Giuzzo/Giuzzo.github.io/404.md

---
layout: center
permalink: /404.html
---

# 404

Sorry, we can't seem to find this page's pixylls.

<div class="mt3">
  <a href="{{ site.baseurl }}/" class="button button-blue button-big">Home</a>
  <a href="{{ site.baseurl }}/contact/" class="button button-blue button-big">Contact</a>
</div>
