Giuzzo/Giuzzo.github.io/_posts/2015-06-25-1.8 progetazzione case - taglio laser - Copia.markdown

---
published: true
title: 1.8 Progettazione case - Laser Cut
layout: post
---

Tutti i pannelli di copertura esterni, e le sponde divisorie interne sono state ricavate da pannelli di parapan di 4mm di spessore.
Nello specifico sono stati utilizzati due pannelli di 1200 X 900 mm, e due panneli più piccoli di 600 X 300 mm.
Sono stati eseguiti dei test preliminari su alcuni provini di materiale per poter calibrare velocità è potenza del laser sul materiale in questione per le diverse lavorazioni necessarie (taglio ed engraving).
Il tempo macchina complessivo per realizzare tutte le lavorazioni è stato di circa 5 ore.

Di seguito i disegni di taglio:

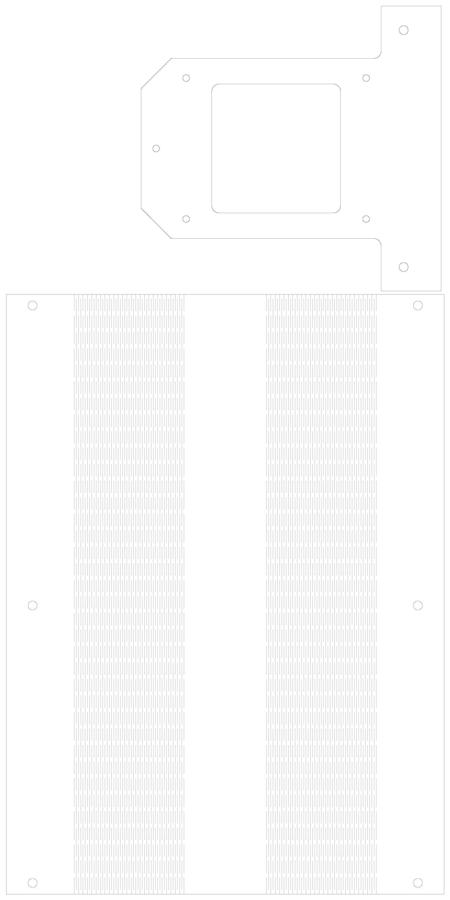
[picture p1: link_img/36.jpg]
laser1
 

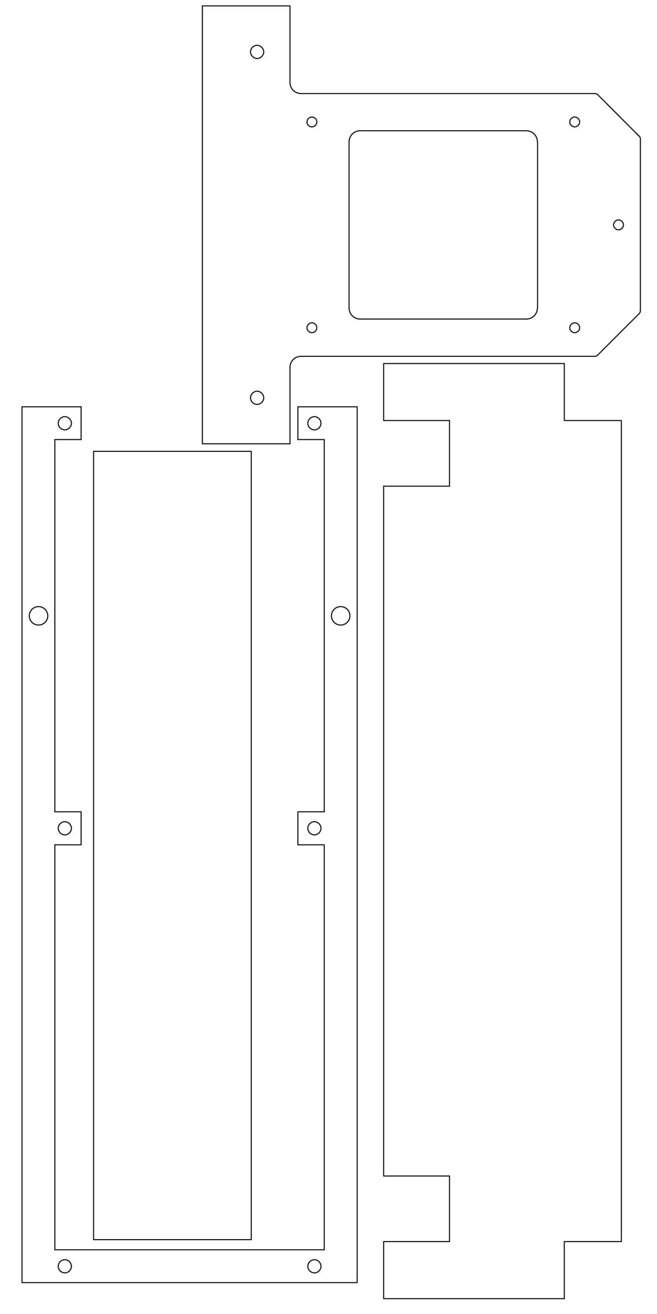
[picture p2: link_img/37.jpg]
laser2


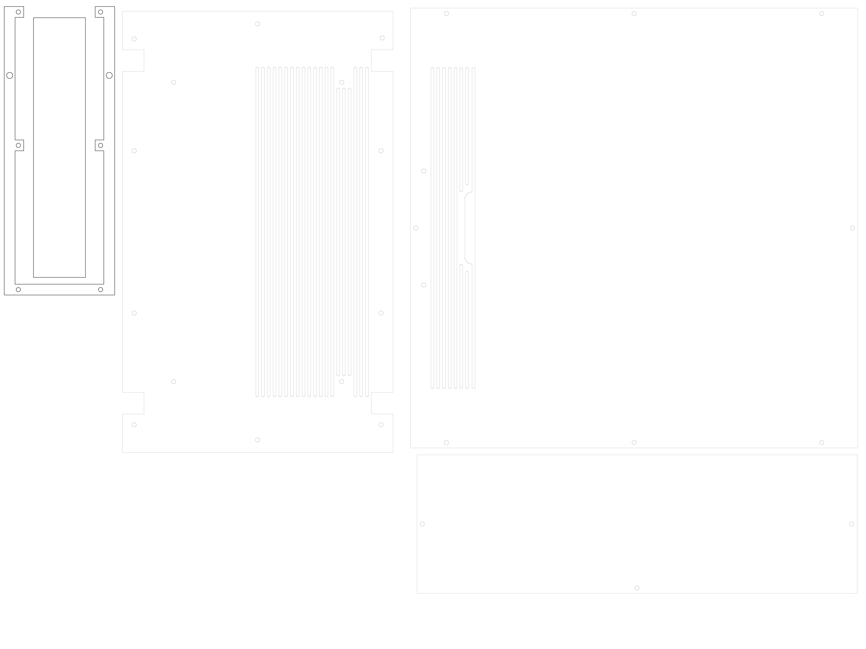
[picture p3: link_img/38.jpg]
laser3


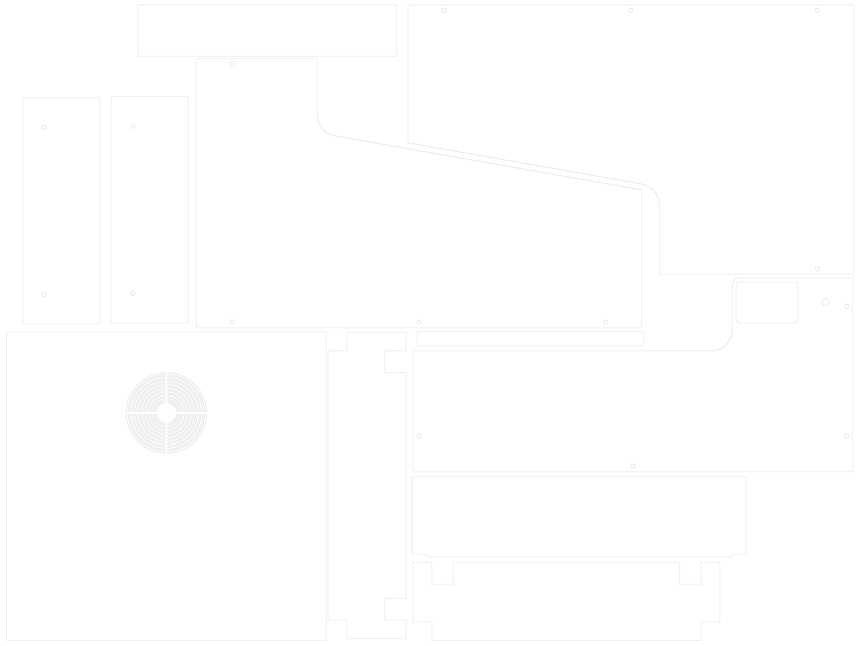
[picture p4: link_img/39.jpg]
laser4
