Giuzzo/Giuzzo.github.io/_posts/2015-05-22-1.4 modellazione 3drag.markdown

---
published: true
title: 1.4 Modellazione 3drag
layout: post
---
Parallelamente alle prime ipotesi di concept, e agli sketch preliminari del case si è proceduto con la modellazione digitale dei componenti e degli ingombri principali della stampante. 
Le istruzioni per il montaggio sono disponibili su [rep rap](http://reprap.org/wiki/3drag) parte dei componenti in formato STL sono invece pubblicate su [thingiverse](http://www.thingiverse.com/thing:203292/#files).

La modellazione è stata fatta con la versione studenti del software di modellazione parametrica [Autodesk Inventor](http://www.autodesk.it/products/inventor/overview). 

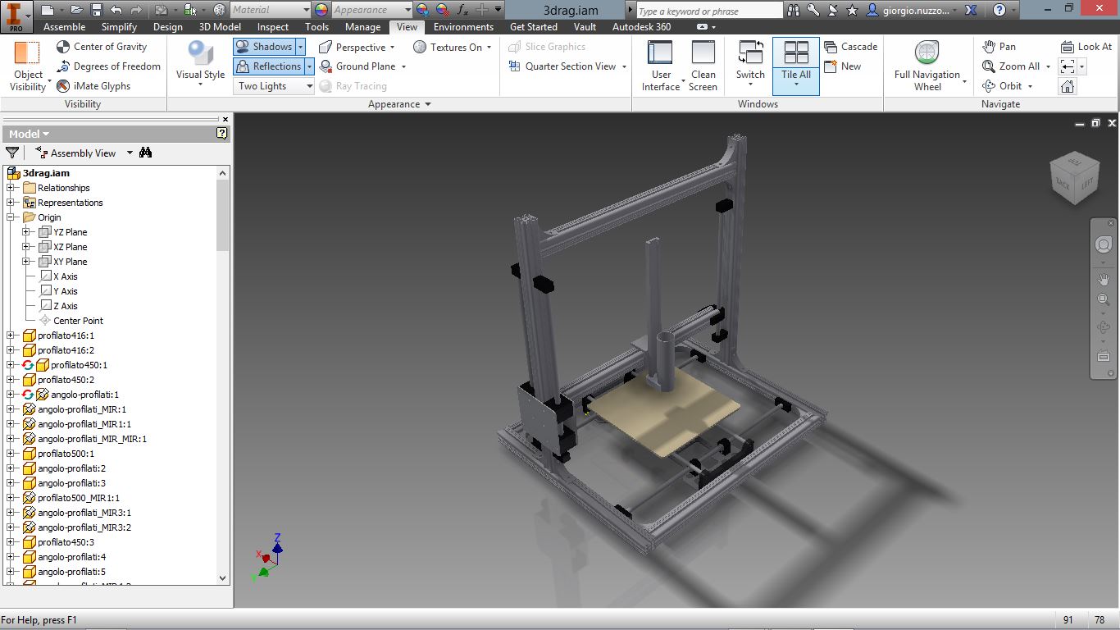
[picture p5: link_img/30.JPG]
3drag_model
