Giuzzo/Giuzzo.github.io/_posts/2015-05-16-0.1 hello-world.markdown

---
published: true
title: Hello world
layout: post
---
This is a test post for my new blog. The blog is hosted on [Github Pages](http://pages.github.com/) which means the source is available at [github.com/Giuzzo/Giuzzo.github.io](http://github.com/Giuzzo/Giuzzo.github.io). Be nice. Give credit. Share, don't steal :)

By the way, this blog is powered by [tinypress.co](https://tinypress.co).
