Giuzzo/Giuzzo.github.io/_posts/2015-05-21-1.3 progettazione case - stato dell'arte.markdown

---
published: true
title: 1.3 Progettazione Case - Stato dell'arte
layout: post
---
In prima battuta è stata fatta una raccolta di case history. 
Sono state analizzate in primo luogo macchine con funzioni analoghe e strettamente legate all'ambito alimentare, poi si è allargato il campo anche a tradizionali stampanti 3d e frese da banco.

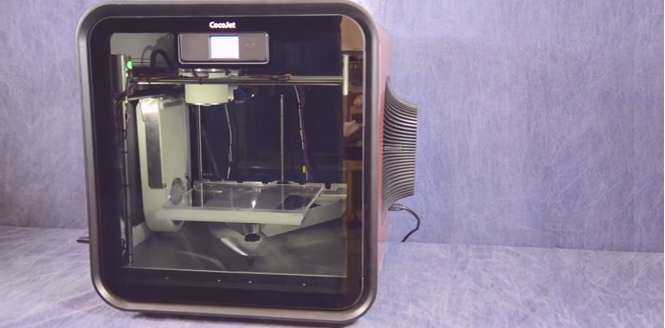
[picture p6: link_img/22.png]
CocoJet

[CocoJet](http://www.3dsystems.com/de/node/7563)

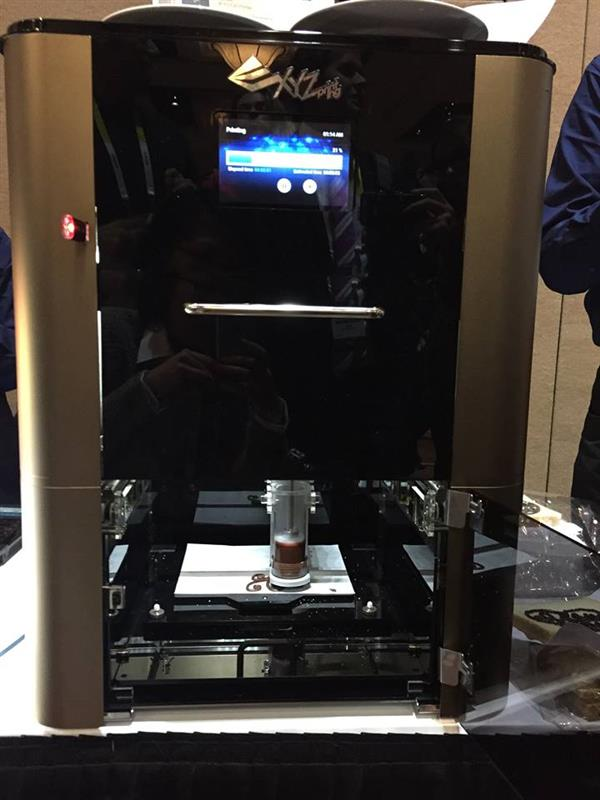
[picture p7: link_img/25.jpg]
xyz_printing

[xyz_foodprinting](http://www.cnet.com/products/xyzprinting-food-printer/)

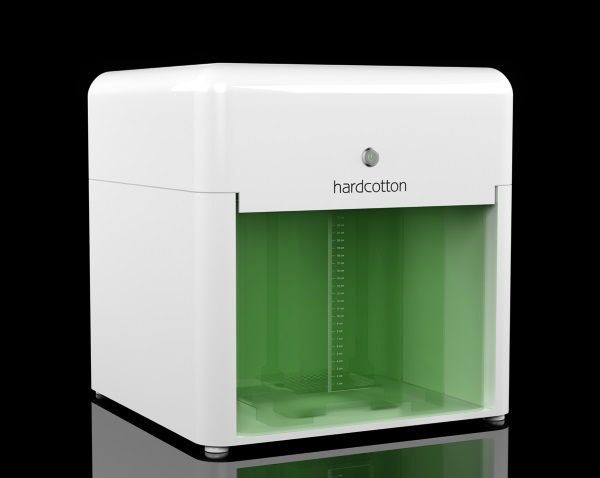
[picture p8: link_img/26.jpg]
hardcotton

[hardcotton](http://www.fabbaloo.com/blog/2014/11/21/hardcottons-sla-3d-printer-launches)

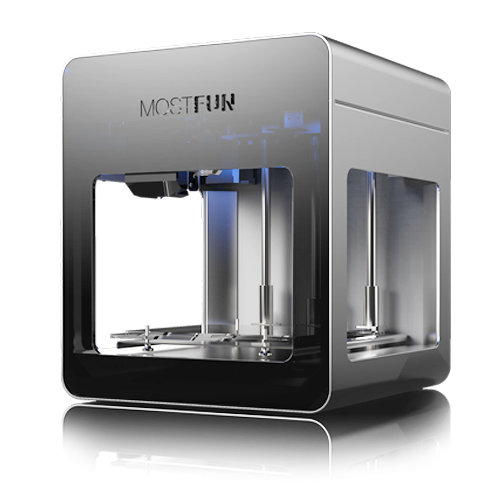
[picture p9: link_img/27.png]
mostfun

[mostfun](http://www.mostfun.cc/)

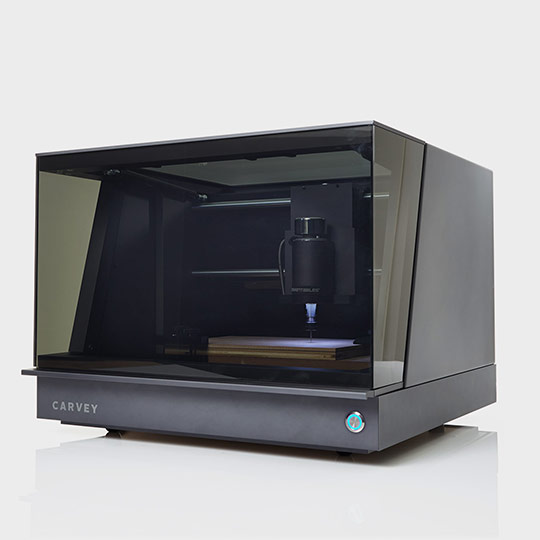
[picture p10: link_img/28.jpg]
carvey1

carvey2
[Carvey](https://www.inventables.com/technologies/carvey)

Ci è sembrato molto interessante in particolare l'espediente utilizzato dalla fresa [Carvey](https://www.inventables.com/technologies/carvey) riguardo l'apertura dello sportello, che risulta essere un'ottimo compromesso fra copertura della meccanica e dell'elettronica della macchina utensile e visibilita del "work in progress".
Questa ha infatti uno sportello di apertura trasparente che occupa la quasi totalità del fronte e solo parzialmente l'area superiore a laterale.
