Giuzzo/Giuzzo.github.io/_posts/2015-05-19-2.4 font monoline.markdown

---
published: true
title: 2.4 Font monoline
layout: post
---
Oltre ad i font selezionati si è cercato di svillupare un modo per poter ottenere un testo scritto con una linea unica continua (senza che l'estrusore si stacchi mai dal piano all'interno della stessa parola) in modo da ottenere un'effetto simile a quello di una **scrittura calligrafica**.

Il primo tentativo è stato quello di ottenere un STL in cui il corpo delle lettere fosse formato da una singola superficie e non da un volume.

Semplificando il problema alle due dimensioni,normalmente tutti i font hanno un proprio corpo che viene scalato in funzione delle proprie dimensioni.
E' stato possibile ottenere dei testi che fossero formati da una linea singola grazie ad un'estenione del software di grafica os [Inkscape](https://inkscape.org/).

L'estensione in questione utilizza dei Font Hershey, ed è scaricabile a  [questo link](http://www.evilmadscientist.com/2011/hershey-text-an-inkscape-extension-for-engraving-fonts/) nel quale sono presenti anche le istruzioni per l'installazione e l'utilizzo.

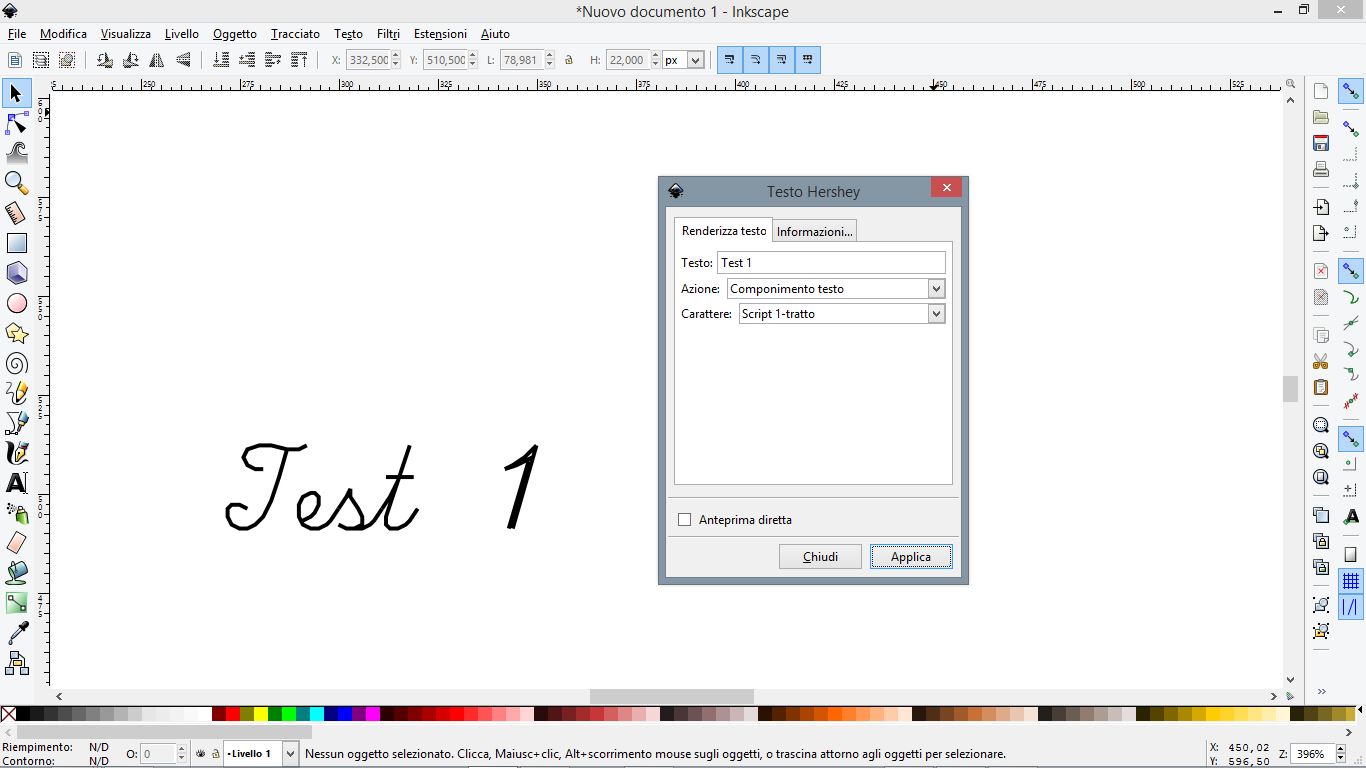
[picture p14: link_img/21.JPG]
testoHershey


Una volta scritto il testo desiderato è possibile esportarlo in un formato CAD e ricavare l'STL estrudendo la geometria su un qualunque programma di modellazione per superfici. Nel caso specifico è stato utilizzato il software [Rhinoceros](https://www.rhino3d.com/it/).

Ovviamente non è possibile in questo caso semplificare l'operazione con OpenScad come descritto nel [post precedente](http://giuzzo.github.io/2015/05/18/test%20di%20stampa%20font.html), in quanto non è possibile utilizzare softwares che lavorino per solidi in quanto questi non permettono l'estrusione di una linea senza spessore.

Cura tuttavia non riesce tuttavia a gestire correttamente lo slicing di singole superfici.

Risultati apprezzabili sono stati ottenuti però trasformando in Inskape il testo Hershey ottenuto da linea in tracciato pieno. In questo modo è possibile gestire il testo come se si stesse trattando con un font tradizionale, ma lo spessore del corpo dei caratteri è noto a prescindere dalle dimensioni generali del testo. 
Prima di eseguire la trasformazione occorre quindi assegnare al testo uno spessore di linea uguale, o prossimo alla dimensione dell'ugello impostata su Cura, dopodichè si può proseguire come [precedentemente descritto](http://giuzzo.github.io/2015/05/18/test%20di%20stampa%20font.html).

Tuttavia questa operazione, pur dando dei discreti risultati (non sempre ottimali), risulta un pò contorta e difficilmente automatizzabile in un futuro prossimo.
Sarà quindi necessario sperimentare nuove strade per ottenere migliori risultati.
