Giuzzo/Giuzzo.github.io/img/2015-05-17-presentazione2.png

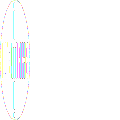
img/2015-05-17-presentazione2.png
