Giuzzo/Giuzzo.github.io/link_img/2-large_default.jpg

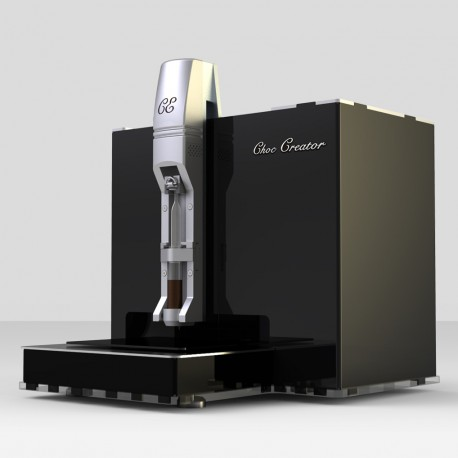
link_img/2-large_default.jpg
