Giuzzo/Giuzzo.github.io/link_img/6.jpg

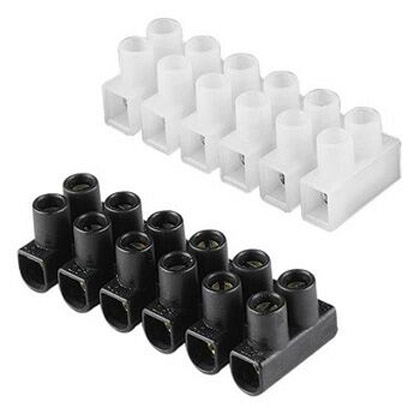
link_img/6.jpg
