Giuzzo/Giuzzo.github.io/link_img/7.jpg

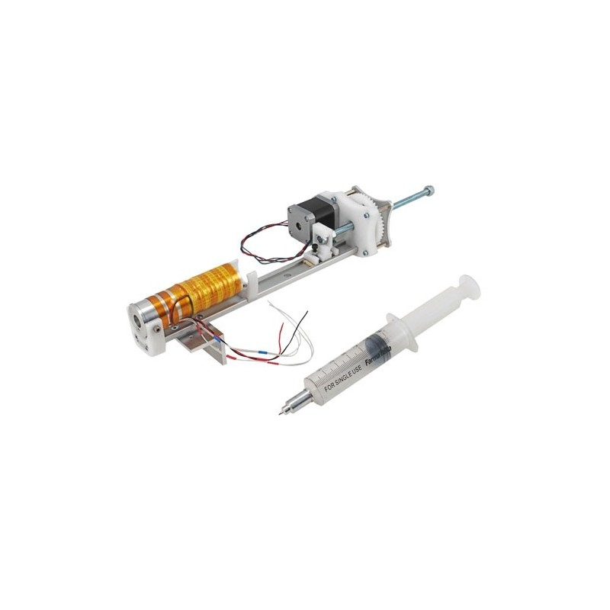
link_img/7.jpg
