Giuzzo/Giuzzo.github.io/link_img/23.jpg

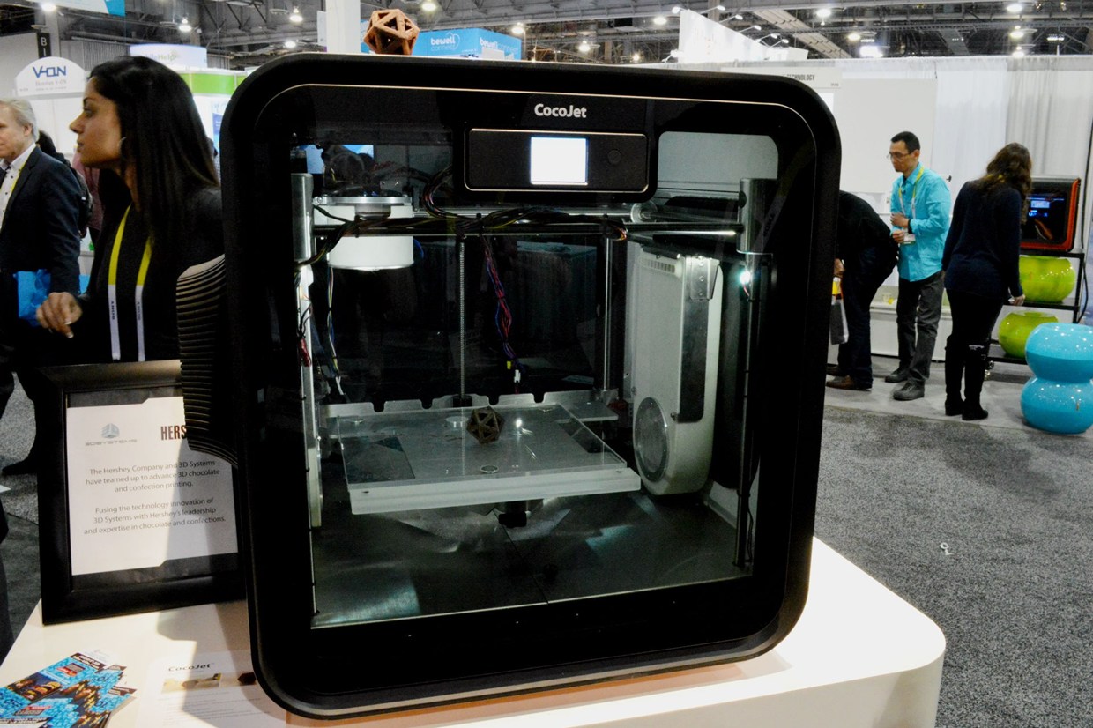
link_img/23.jpg
