Giuzzo/Giuzzo.github.io/link_img/24.png

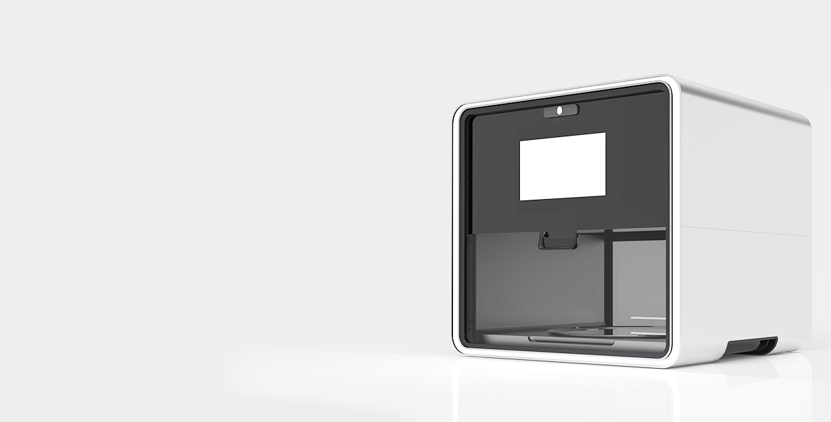
link_img/24.png
