Giuzzo/Giuzzo.github.io/link_img/29.jpg

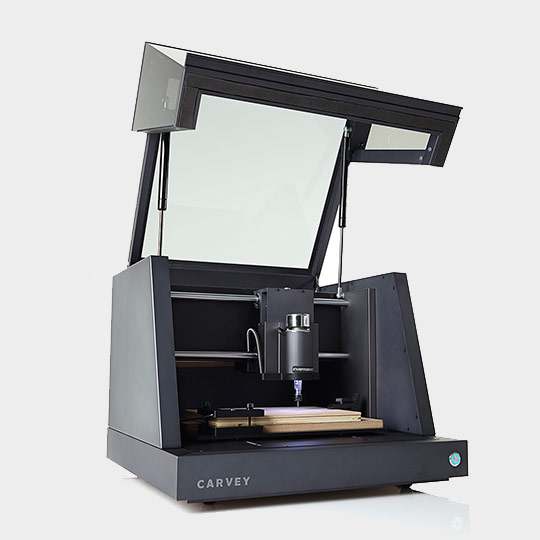
link_img/29.jpg
