Giuzzo/Giuzzo.github.io/link_img/34.png

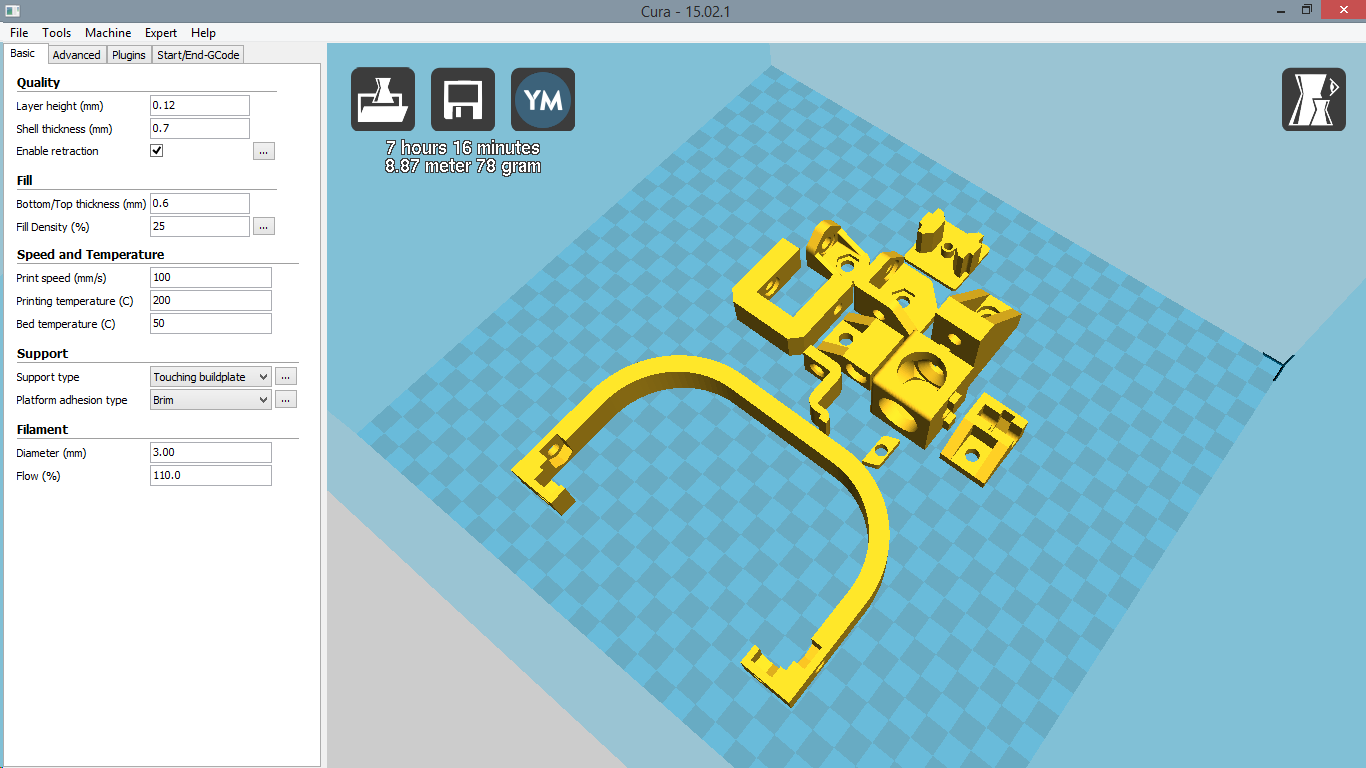
link_img/34.png
