Giuzzo/Giuzzo.github.io/link_img/35.png

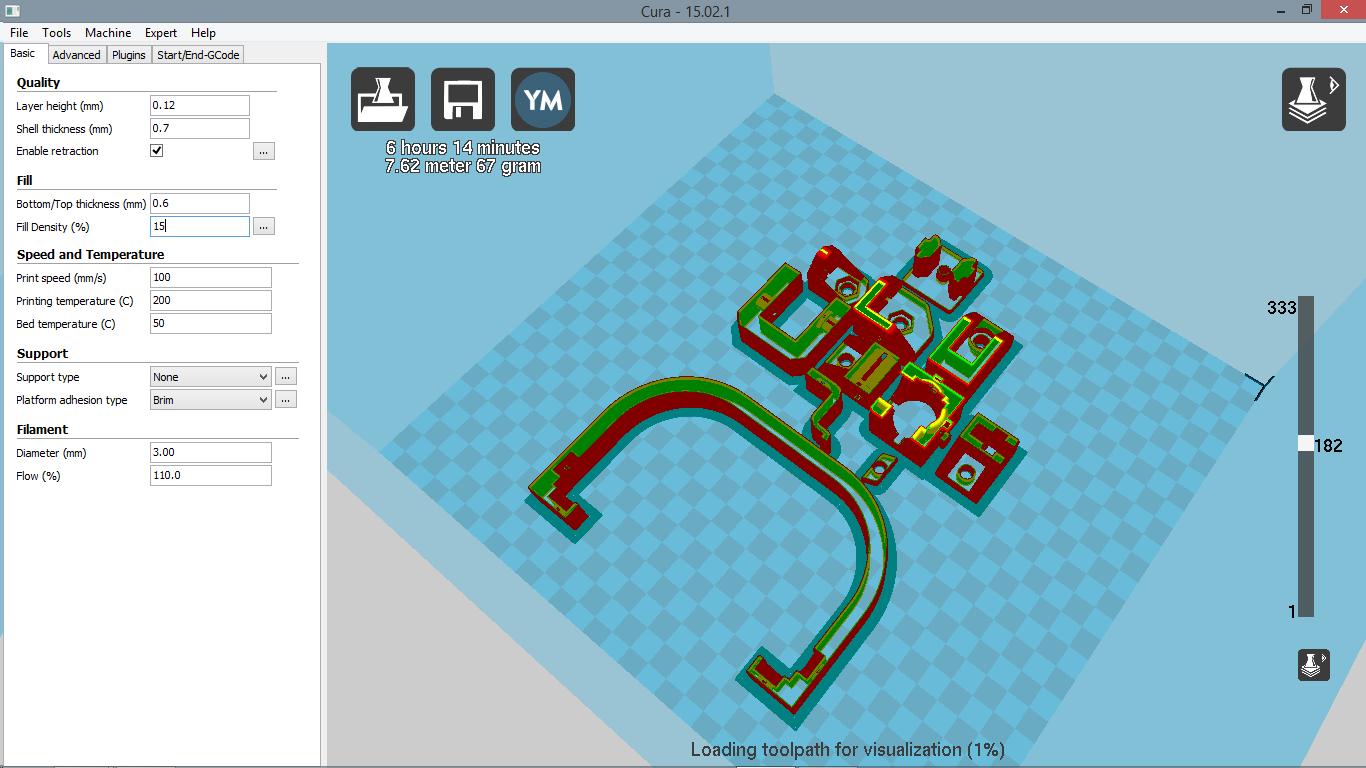
link_img/35.png
