Giuzzo/Giuzzo.github.io/_posts/2015-06-06-1.6 progetazzione case - bom.markdown

---
published: true
title: 1.6 Progettazione case - Bom
layout: post
---

Dopo gli sketch e le ipotesi preliminari si è iniziata la modellazione, cintemporaneamente all'ingenierizzazione del case, considerando sempre le tecnologie disponibili all'interno di WeMake.
Il telaio strutturale sara costituito da profilati in alluminio acquistati da un'azienda esterna, nella fattispecie [Dierre Toscana](http://dierre.eu/profili-e-sistemi-modulari/comp-di-assemblaggio-br-span-per-profili-span).

Di seguito delle immagine del modello digitale della configurazione finale del case, in fondo è riportata la distinta dei componenti utilizzati.

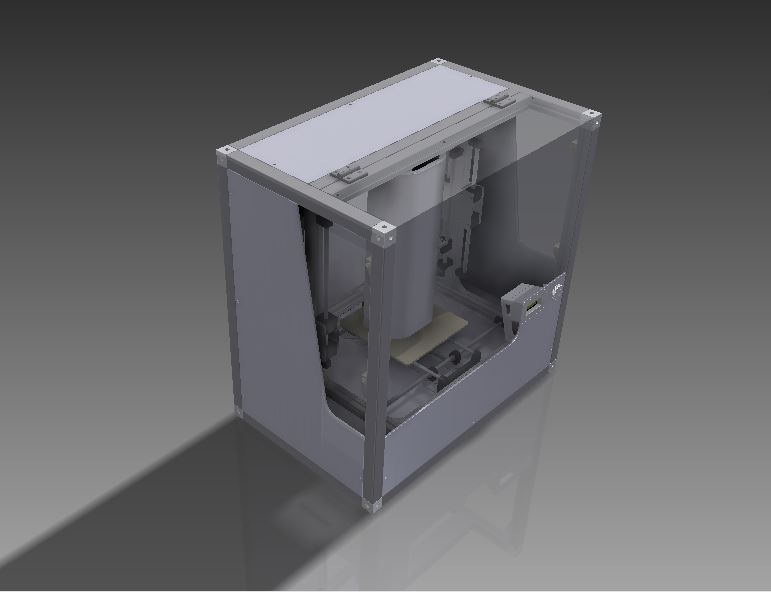
[picture p26: link_img/31.JPG]
case1


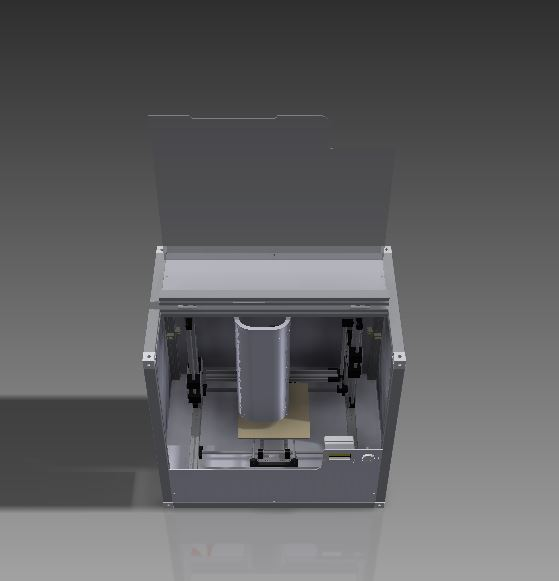
[picture p27: link_img/32.JPG]
case2


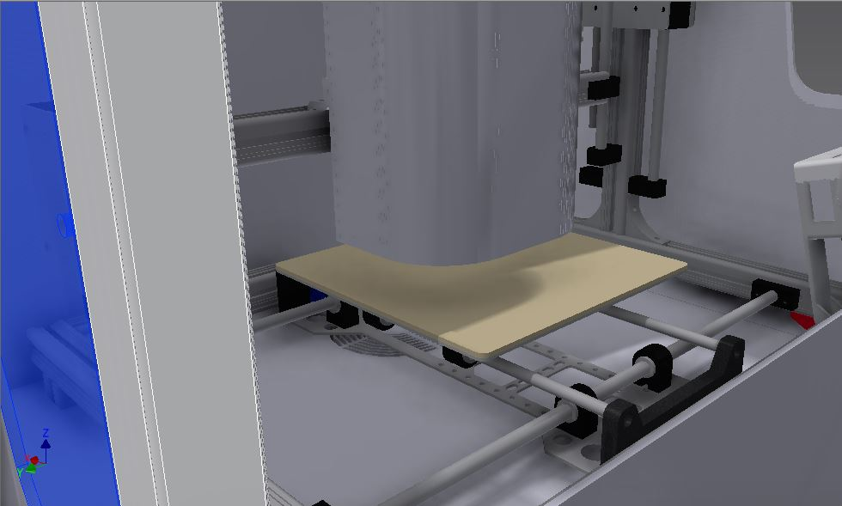
[picture p28: link_img/33.JPG]
case3


###Bill of Materials

| Assieme | Denominazione assieme | Parte | Denominazione| N° | M o B | Fornitore | Codice Fornitore | Dimensioni | Materiale | Lavorazione |
|:---:|:---:|:---:|:---:|:---:|:---:|:---:|:---:|:---:|:---:|:---:|
| 1 | 3drag | 1 | 3drag choko | 1  | B | FuturaElettronica | | | | |
| 2 | struttura portante | 02.01 | profilati verticali | 4  | B | DierreToscana | 01.30.30.2A | L 620 mm | alluminio | |
| | | 02.02 | profilati orizzontali | 3  | B | DierreToscana | 01.30.30.2A | L 610 mm | alluminio | |
| | | 02.03 | profilati orizzontali/lato | 4  | B | DierreToscana | 01.30.30.2A | L 375 mm | alluminio | |
| | | 02.04 | profilati orizzontali/cave180 | 2  | B | DierreToscana | 01.30.30.2.180A  | L 610 mm | alluminio | |
| | | 02.05 | cerniere | 2  | B | DierreToscana | 15-163-00 | | alluminio | |
| | | 02.06 | profilati di collegamento 3drag | 4  | B | DierreToscana | 01-3030-4A | L 136 mm | alluminio | |
| | | 02.07 | giunti angolari | 8  | M | | | | PLA | 3d printing |
| | | 02.08 | supporto piedini | 4  | M | | | | PLA | 3d printing |
| | | 02.09 | piedini | 4  | M | FuturaElettronica | | | | |
| 3 | schocche | 03.01 | blocco pannelli | 41 | M | | | | PLA | 3d printing |
| | | 03.02 | staffa angolare foro/foro | 2  | M | | | | PLA | 3d printing |
| | | 03.03 | staffa angolare foro/dado | 4  | M | | | | PLA | 3d printing |
| | | 03.04 | staffa angolare  dado/dado | 6  | M | | | | PLA | 3d printing |
| | | 03.05 | giunto basso | 2  | M | | | | PLA | 3d printing |
| | | 03.06 | giunto basso mirror | 2  | M | | | | PLA | 3d printing |
| | | 03.07 | fissaggio base inferiore | 6  | M | | | | PLA | 3d printing |
| | | 03.08 | giunto a U superiore | 2  | M | | | | PLA | 3d printing |
| | | 03.09 | pannello piano inferiore | 1  | M | | | | parapan 5mm | laser cut |
| | | 03.10 | pannello superiore | 1  | M | | | | parapan 5mm | laser cut |
| | | 03.11 | pannello posteriore | 1  | M | | | | parapan 5mm | laser cut |
| | | 03.12 | piano superiore fisso | 2  | M | | | | parapan 5mm | laser cut |
| | | 03.13 | binario piano superiore | 2  | M | | | | parapan 5mm | laser cut |
| | | 03.14 | piano superiore scorrevole | 1  | M | | | | parapan 5mm | laser cut |
| | | 03.15 | sponda divisoria frigo | 1  | M | | | | parapan 5mm | laser cut |
| | | 03.16 | sponda divisoria laterale | 2  | M | | | | parapan 5mm | laser cut |
| | | 03.17 | pannello opaco destro | 1  | M | | | | parapan 5mm | laser cut |
| | | 03.18 | pannello opaco sinistro | 1  | M | | | | parapan 5mm | laser cut |
| | | 03.19 | pannello frontale | 1  | M | | | | parapan 5mm | laser cut |
| | | 03.20 | pannello trasparente destro | 1  | M | | | | plexy 3mm | laser cut |
| | | 03.21 | pannello trasparente sinistro | 1  | M | | | | plexy 3mm | laser cut |
| | | 03.22 | sportello front | 1  | M | | | | plexy 3mm | laser cut |
| | | 03.23 | sportello up | 1  | M | | | | plexy 5mm | laser cut |
| | | 03.24 | saette sportello | 2  | M | | | | plexy 5mm | laser cut |
| 4 | copri-estrusore | 04.01 | dima estrusore | 3  | M | | | | PLA | 3d printing |
| | | 04.02 | copri-estrusore | 1  | M | | | | parapan 5mm | laser cut |
| | | 04.03 | retro copri-estrusore | 1  | M | | | | parapan 5mm | laser cut |
| | | 04.04 | fissaggio copri-estrusore | 2  | M | | | | PLA | 3d printing |
| | | 04.05 | magneti copri-estrusore | 4  | B | WeMake | | | | |
| 5 | frigo | 05.01 | frigo | 1  | B | Lidl | | | | |
| | | 05.02 | blocco frigo | 1  | M | | | | parapan 5mm | laser cut |
| | | 05.03 | convogliatore frigo | 1  | M | | | | PLA | 3d printing |
| 6 | LCD | 06.01 | blocco 1LCD | 1  | M | | | | PLA | 3d printing |
| | | 06.02 | blocco 2LCD | 1  | M | | | | PLA | 3d printing |
| | | 06.03 | manopola LCD | 1  | M | | | | PLA | 3d printing |
| 7 | fasteners | 07.01 | cursori a martello | 73 | B (M) | DierreToscana | 26-070-00 | | alluminio(PLA) | |
| | | 07.02 | viti M6 testa bombata | 41 | B | FerramentaBorchiola | | L 18 mm | | |
| | | 07.03 | viti M8 | 22 | B | FerramentaBorchiola | | | | |
| | | 07.04 | viti M6 testa bombata | | | FerramentaBorchiola | | L12mm | 
|______|________________________________________________________|_________|_____________________|______|_________|____________________________________|____________|___________|______________|________________|
