Giuzzo/Giuzzo.github.io/img/2015-06-04-progetazzionecase-bom2.png

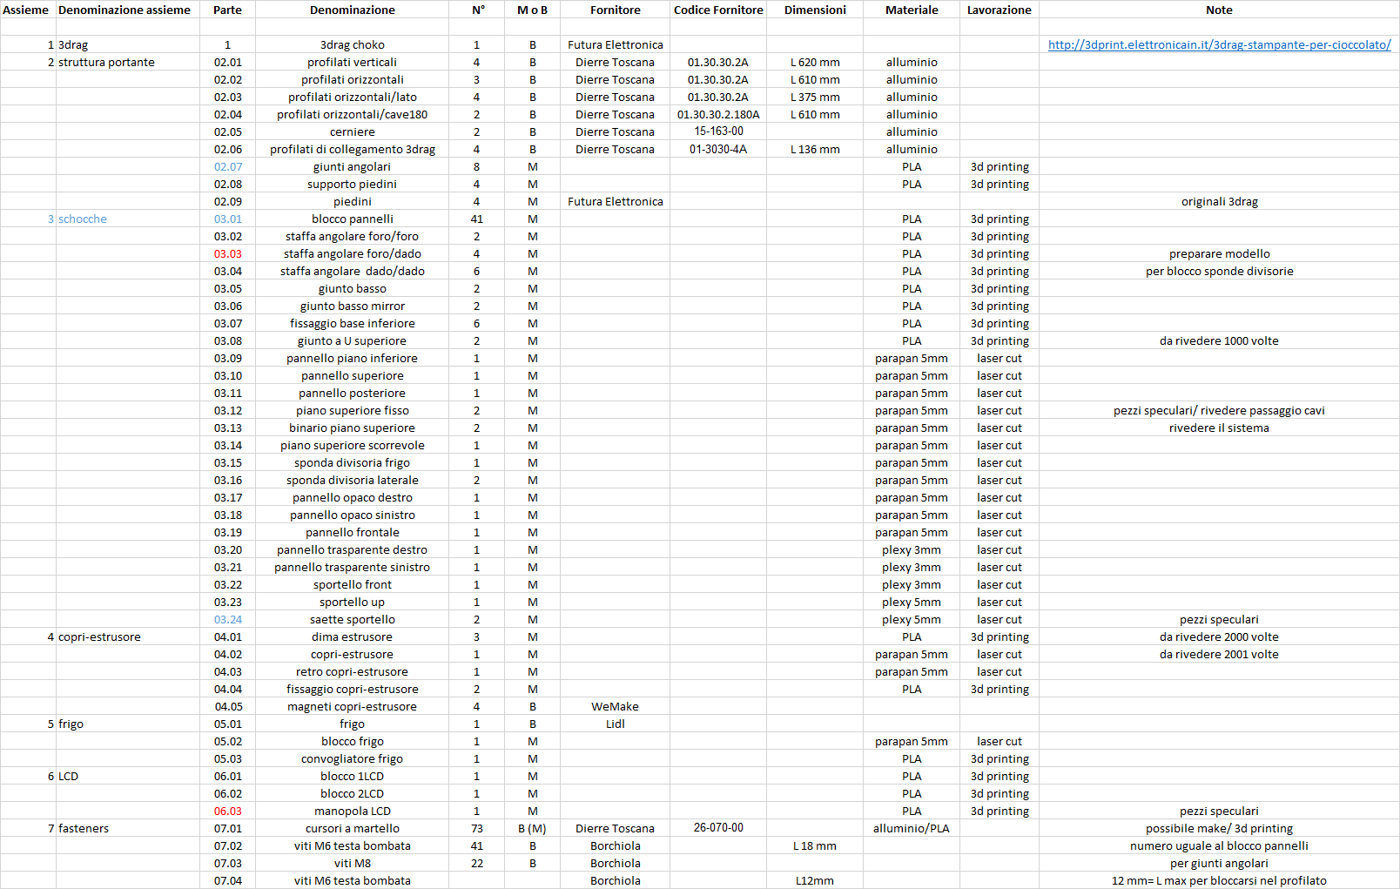
img/2015-06-04-progetazzionecase-bom2.png
