Giuzzo/Giuzzo.github.io/link_modellazione/modello_3drag/3drag.stp

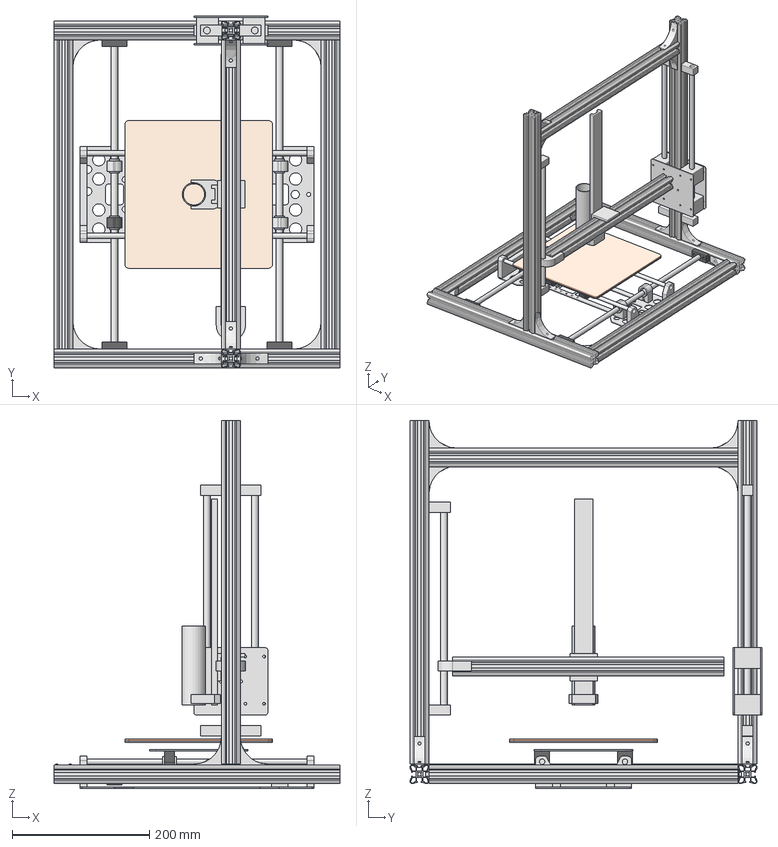
[picture p30: CAD file, 2015-05-22, last stored version]
link_modellazione/modello_3drag/3drag.stp
416.0 x 512.2 x 535.5 mm
