Giuzzo/Giuzzo.github.io/(list of files, cad)

Other CAD files:
link_modellazione/modello_3drag/Templates/English/ANSI (in).dwg
link_modellazione/modello_3drag/Templates/Metric/am_bsi.dwg
link_modellazione/modello_3drag/Templates/Standard.dwg
link_modellazione/modello_3drag/Templates/English/am_ansi.dwg
link_modellazione/modello_3drag/Templates/Metric/DIN.dwg
link_modellazione/modello_3drag/Templates/Metric/JIS.dwg
link_modellazione/modello_3drag/Templates/Metric/BSI.dwg
link_modellazione/modello_3drag/Templates/Metric/am_din.dwg
link_modellazione/modello_3drag/Templates/Metric/am_iso.dwg
link_modellazione/modello_3drag/Templates/Metric/GOST.dwg
link_modellazione/modello_3drag/Templates/Metric/am_gb.dwg
link_modellazione/modello_3drag/Templates/Metric/ISO.dwg
link_modellazione/modello_3drag/Templates/Metric/ANSI (mm).dwg
link_modellazione/modello_3drag/Templates/Metric/GB.dwg
link_modellazione/modello_3drag/Templates/Metric/am_jis.dwg
link_modellazione/modello_3drag/3drag.iam
link_modellazione/modello_3drag/Design Data/AIT/Mold Design/Mold Design Stop Pin.ipt
link_modellazione/modello_3drag/Design Data/Cable & Harness/en-US/harness.iam
link_modellazione/modello_3drag/Design Data/Tube & Pipe/en-US/piping runs.iam
link_modellazione/modello_3drag/Templates/English/ANSI (in).idw
link_modellazione/modello_3drag/Templates/English/Mold Design (in).iam
link_modellazione/modello_3drag/Templates/English/Sheet Metal (in).ipt
link_modellazione/modello_3drag/Templates/English/Standard (in).iam
link_modellazione/modello_3drag/Templates/English/Standard (in).ipn
link_modellazione/modello_3drag/Templates/English/Standard (in).ipt
link_modellazione/modello_3drag/Templates/English/Weldment (ANSI).iam
link_modellazione/modello_3drag/Templates/Metric/ANSI (mm).idw
link_modellazione/modello_3drag/Templates/Metric/BSI.idw
link_modellazione/modello_3drag/Templates/Metric/DIN.idw
link_modellazione/modello_3drag/Templates/Metric/GB.idw
link_modellazione/modello_3drag/Templates/Metric/GOST.idw
link_modellazione/modello_3drag/Templates/Metric/ISO.idw
link_modellazione/modello_3drag/Templates/Metric/JIS.idw
link_modellazione/modello_3drag/Templates/Metric/Mold Design (DIN).iam
link_modellazione/modello_3drag/Templates/Metric/Mold Design (mm).iam
link_modellazione/modello_3drag/Templates/Metric/Sheet Metal (DIN).ipt
link_modellazione/modello_3drag/Templates/Metric/Sheet Metal (mm).ipt
link_modellazione/modello_3drag/Templates/Metric/Standard (DIN).iam
link_modellazione/modello_3drag/Templates/Metric/Standard (DIN).ipn
link_modellazione/modello_3drag/Templates/Metric/Standard (DIN).ipt
link_modellazione/modello_3drag/Templates/Metric/Standard (mm).iam
link_modellazione/modello_3drag/Templates/Metric/Standard (mm).ipn
link_modellazione/modello_3drag/Templates/Metric/Standard (mm).ipt
link_modellazione/modello_3drag/Templates/Metric/Weldment (ANSI - mm).iam
link_modellazione/modello_3drag/Templates/Metric/Weldment (BSI).iam
link_modellazione/modello_3drag/Templates/Metric/Weldment (DIN).iam
link_modellazione/modello_3drag/Templates/Metric/Weldment (GB).iam
link_modellazione/modello_3drag/Templates/Metric/Weldment (ISO).iam
link_modellazione/modello_3drag/Templates/Metric/Weldment (JIS).iam
link_modellazione/modello_3drag/Templates/Mold Design/Mold Design.iam
link_modellazione/modello_3drag/Templates/Sheet Metal.ipt
link_modellazione/modello_3drag/Templates/Standard.iam
link_modellazione/modello_3drag/Templates/Standard.idw
link_modellazione/modello_3drag/Templates/Standard.ipn
link_modellazione/modello_3drag/Templates/Standard.ipt
link_modellazione/modello_3drag/Templates/Weldment.iam
link_modellazione/modello_3drag/Y axys.iam
link_modellazione/modello_3drag/angolo-profilati.ipt
link_modellazione/modello_3drag/angolo-profilati_MIR.ipt
link_modellazione/modello_3drag/angolo-profilati_MIR1.ipt
link_modellazione/modello_3drag/angolo-profilati_MIR3.ipt
link_modellazione/modello_3drag/angolo-profilati_MIR4.ipt
link_modellazione/modello_3drag/angolo-profilati_MIR5.ipt
link_modellazione/modello_3drag/angolo-profilati_MIR_MIR.ipt
link_modellazione/modello_3drag/barra X.ipt
link_modellazione/modello_3drag/barra X_MIR.ipt
link_modellazione/modello_3drag/barraY.ipt
link_modellazione/modello_3drag/barraY_MIR.ipt
link_modellazione/modello_3drag/cuscinettoY.ipt
link_modellazione/modello_3drag/cuscinettoY_MIR2.ipt
link_modellazione/modello_3drag/cuscinettoY_MIR2_MIR.ipt
link_modellazione/modello_3drag/cuscinettoY_MIR3.ipt
link_modellazione/modello_3drag/cuscinetto_X.ipt
link_modellazione/modello_3drag/cuscinetto_X_MIR.ipt
link_modellazione/modello_3drag/cuscinetto_X_MIR1.ipt
link_modellazione/modello_3drag/cuscinetto_X_MIR_MIR.ipt
link_modellazione/modello_3drag/giunto_barra_estrusore.ipt
link_modellazione/modello_3drag/giunto_fondo_siringa.ipt
link_modellazione/modello_3drag/guida_Z.ipt
link_modellazione/modello_3drag/guida_Z_MIR.ipt
link_modellazione/modello_3drag/guida_Z_MIR1.ipt
link_modellazione/modello_3drag/guida_Z_MIR_MIR.ipt
link_modellazione/modello_3drag/guida__Z.ipt
link_modellazione/modello_3drag/piastraX.ipt
link_modellazione/modello_3drag/piastraY.ipt
link_modellazione/modello_3drag/piastra_manicotti.ipt
link_modellazione/modello_3drag/piastra_manicotti_MIR.ipt
link_modellazione/modello_3drag/piastra_superiore_y.ipt
link_modellazione/modello_3drag/piastra_superiorissima.ipt
link_modellazione/modello_3drag/profilato416.ipt
link_modellazione/modello_3drag/profilato450.ipt
link_modellazione/modello_3drag/profilato450estrusore.ipt
link_modellazione/modello_3drag/profilato500.ipt
link_modellazione/modello_3drag/profilato500_MIR1.ipt
link_modellazione/modello_3drag/profilo_estrusore.ipt
link_modellazione/modello_3drag/staffa_estrusore.ipt
link_modellazione/modello_3drag/supporto guide x.ipt
link_modellazione/modello_3drag/supporto guide x_MIR.ipt
link_modellazione/modello_3drag/supporto guide x_MIR1.ipt
link_modellazione/modello_3drag/supporto guide x_MIR_MIR.ipt
link_modellazione/modello_3drag/supporto_guide_10Z.ipt
link_modellazione/modello_3drag/supporto_guide_10Z_MIR.ipt
link_modellazione/modello_3drag/supporto_guide_10Z_MIR1.ipt
link_modellazione/modello_3drag/supporto_guide_10Z_MIR1_MIR.ipt
link_modellazione/modello_3drag/supporto_guide_10Z_MIR2.ipt
link_modellazione/modello_3drag/supporto_guide_10Z_MIR_MIR.ipt
link_modellazione/modello_3drag/supporto_guide_10Z_MIR_MIR1.ipt
link_modellazione/modello_3drag/supporto_guide_10Z_MIR_MIR_MIR.ipt
link_modellazione/modello_3drag/supporto_guide_corto.ipt
link_modellazione/modello_3drag/supporto_guide_corto_MIR1.ipt
link_modellazione/modello_3drag/supporto_guide_lungo.ipt
link_modellazione/modello_3drag/supporto_manicotto_X.ipt
link_modellazione/modello_3drag/supporto_manicotto_X_MIR.ipt
link_modellazione/modello_3drag/supporto_manicotto_X_MIR1.ipt
link_modellazione/modello_3drag/supporto_manicotto_X_MIR4.ipt
link_modellazione/modello_3drag/supporto_manicotto_X_MIR4_MIR.ipt
link_modellazione/modello_3drag/supporto_manicotto_X_MIR5.ipt
link_modellazione/modello_3drag/supporto_manicotto_X_MIR_MIR.ipt
link_modellazione/modello_3drag/supporto_manicotto_Z.ipt
link_modellazione/modello_3drag/supporto_manicotto_Z_MIR.ipt
link_modellazione/modello_3drag/supporto_manicotto_Z_MIR1.ipt
link_modellazione/modello_3drag/supporto_manicotto_Z_MIR1_MIR.ipt
link_modellazione/modello_3drag/supporto_manicotto_Z_MIR2.ipt
link_modellazione/modello_3drag/supporto_manicotto_Z_MIR_MIR.ipt
link_modellazione/modello_3drag/supporto_manicotto_Z_MIR_MIR1.ipt
link_modellazione/modello_3drag/supporto_manicotto_Z_MIR_MIR_MIR.ipt
link_modellazione/modello_3drag/tubo_coprisiringa.ipt
link_modellazione/modello_3drag/x axys.iam
link_modellazione/modello_3drag/z_axys.iam
link_modellazione/modello_3drag/z_axys_MIR.iam
link_modellazione/modello_3drag/z_axys_MIR1.iam
link_modellazione/modello_3drag/z_axys_MIR_MIR.iam
link_modellazione/modello_3drag/z_axys_extrusorù.iam
