Giuzzo/Giuzzo.github.io/_posts/2015-05-17-1.1 assemblaggio 3drag choko.markdown

---
published: true
title: 1.1 Assemblaggio 3drag Choco
layout: post
---
In prima battuta si è manifestata l'esigenza di avere una seconda **stampante per il cioccolato** oltre a quella già presente.
Da premettere la possibilità di una partecipazione di MyChock all' Expo2015 di Milano. 
Avere due stampanti funzionanti poterne avere una "stabile" per eventuali futuri ordini di barrette, ed una seconda sulla quale lavorare per la progettazione del case e sulla quale sia possibile sperimentare miglioramenti tecnologici, che sia disponibile anche per delle demo in eventi futuri.

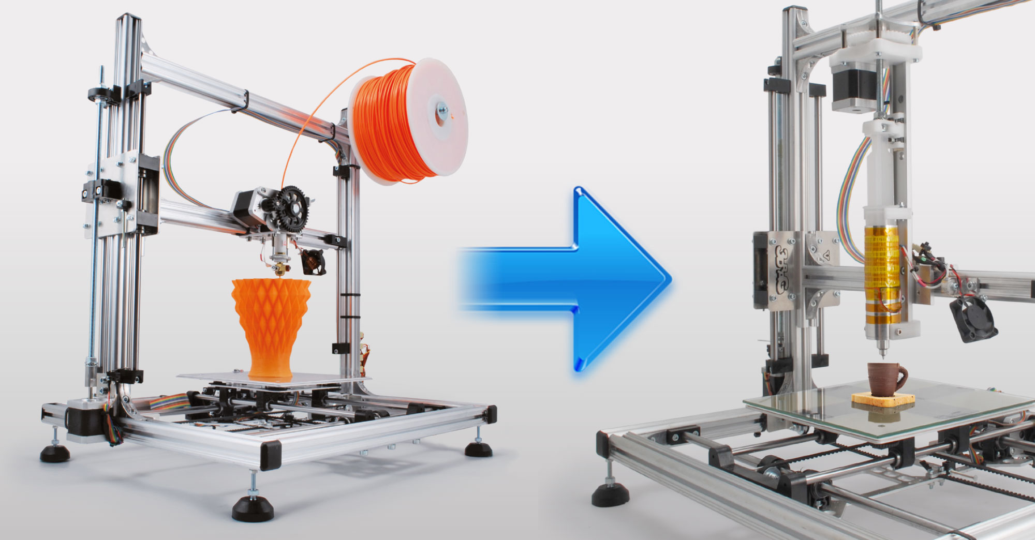
[picture p31: _images/4.jpg]
3drag choko


Le stampanti in questione sono delle **3drag**, stampanti  FDM che lavorano con materiali plastici, sulle quali viene sostituito all'estrusore tradizionale un sistema di estrusione per il cioccolato a siringa.
Sia la stampante che il kit di modifica del sistema estrusore sono acquistabili sul sito di shop della casa produttrice **Futura Elettronica**. [futurashop](https://www.futurashop.it/)

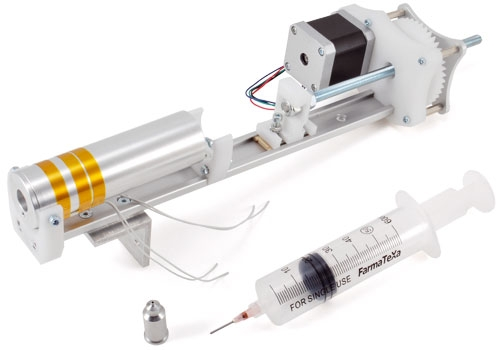
[picture p32: _images/5.jpg]
estrusore choco


Istruzioni dettagliate sull'assemblaggio del kit per la stampa del cioccolato al [link](http://3dprint.elettronicain.it/3drag-stampante-per-cioccolato/).

A differenza di quanto illustrato nel link sovracitato l'utilizzo di un morsetto mammut per il cablaggio può rendere il lavoro più agevole ed ordinato.

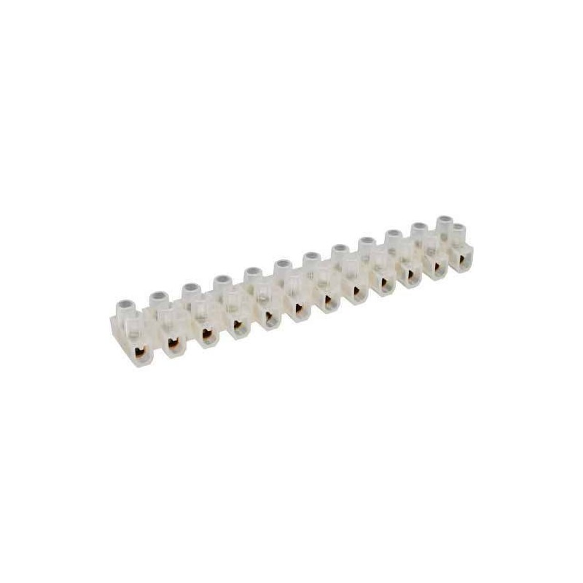
[picture p33: link_img/8.jpg]
morsetto mammut


[Disegni tecnici](http://www.open-electronics.org/wp-content/uploads/2014/10/Disegni-tecnici.jpg) dettagliati dei componenti presenti nel kit. Parte di questi sono stampabili 3d, quindi modificabili in funzione delle proprie esigenze.

Oltre all'assemblaggio del kit, è necessaria anche una modifica software del [firmware Marlin](http://3dprint.elettronicain.it/2012/09/06/software/).
