Giuzzo/Giuzzo.github.io/fonts_testati/font.pdf

www.fontsquirrel.com

## Quicksand Bold

abcdefghilmnopqrstuvwxyz
ABCDEFGHILMNOPQRSTUVWXYZ
0123456789
!/|\+*#^°@àéèùìç?-_<>”’&%£€@©{[(

dimensione minima 7,5 mm

# Raleway Bold

abcdefghilmnopqrstuvwxyz
ABCDEFGHILMNOPQRSTUVWXYZ
0123456789
!/|\+*#^°@àéèùìç?-_<>”’&%£€@©{[(

dimensione minima 10 mm

# Noto Serif Regular

abcdefghilmnopqrstuvwxyz
ABCDEFGHILMNOPQRSTUVWXYZ
0123456789
!/|\+*#^°@àéèùìç?-_<>”’&%£€@©{[(

dimensione minima 15 mm

www.fontsquirrel.com

# Latin Modern Mono Light 10Bold

abcdefghilmnopqrstuvwxyz
ABCDEFGHILMNOPQRSTUVWXYZ 0123456789 !/|\+*#^°@àéèùìç?-_<>”’&%£€@©{[(

dimensione minima 15 mm

# LeckerliOne Regular

abcdefghilmnopqrstuvwxyz
ABCDEFGHILMNOPQRSTUVWXYZ
0123456789
!/|\+*#^°@àéèùìç?-_<>”’&%£€@©{[(

dimensione minima 15 mm
