Giuzzo/Giuzzo.github.io/_posts/2015-05-18-2.2 test di stampa cioccolato.markdown

---
published: true
title: 2.2 Test di stampa cioccolato
layout: post
---
Dopo i test preliminari si è proceduto con delle prove di stampa con il cioccolato.
In prima battuta sono state utilizzate delle **goccie di cioccolato bianco**.

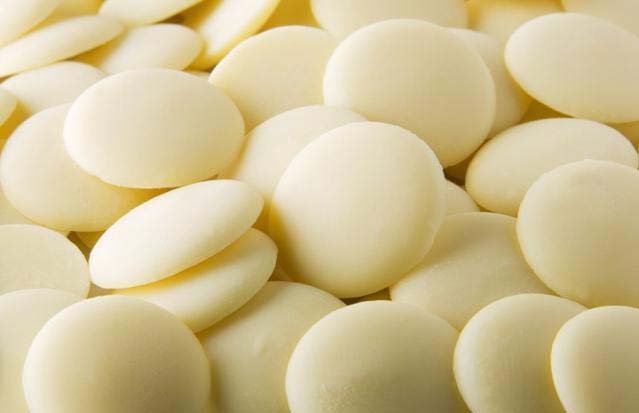
[picture p37: link_img/13.jpg]
cioccolato bianco


Per agevolare ed accelerare l'operazione di fusione del cioccolato è stata utilizzata una cioccolatiera elettrica. In fase di raffreddamento la temperatura è stata monitorata con l'ausilio di un termometro digitale da cucina.

Per maggiori informazioni su quali siano le corrette temperature necessarie per la tempra del cioccolato vai al [link](http://www.coquinaria.it/archivio/cioccolato/temperaggio.html).

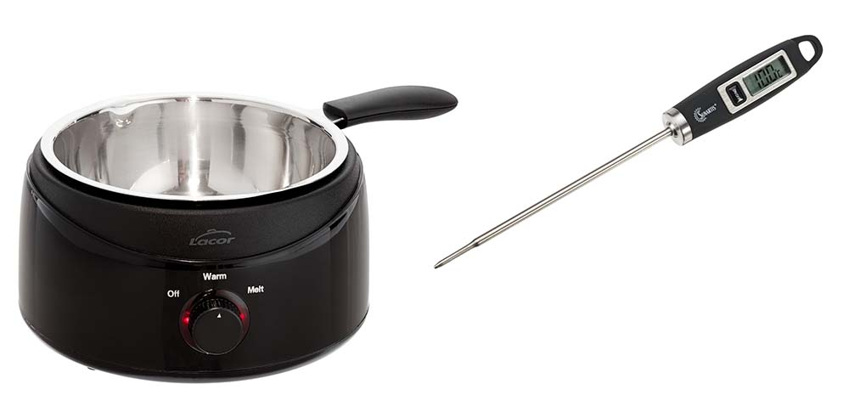
[picture p38: link_img/12.jpg]
cioccolatiera + termometro


Per quanto riguarda le operazioni successive risultano uguali a quanto già visto nei test preliminari, per quanto il cioccolato fuso risulti essere leggermente più denso della maionese per cui bisogna avere maggiore accortezza nel rimuovere l'aria dalla siringa.

Lo slicing è stato effettuato con Cura.

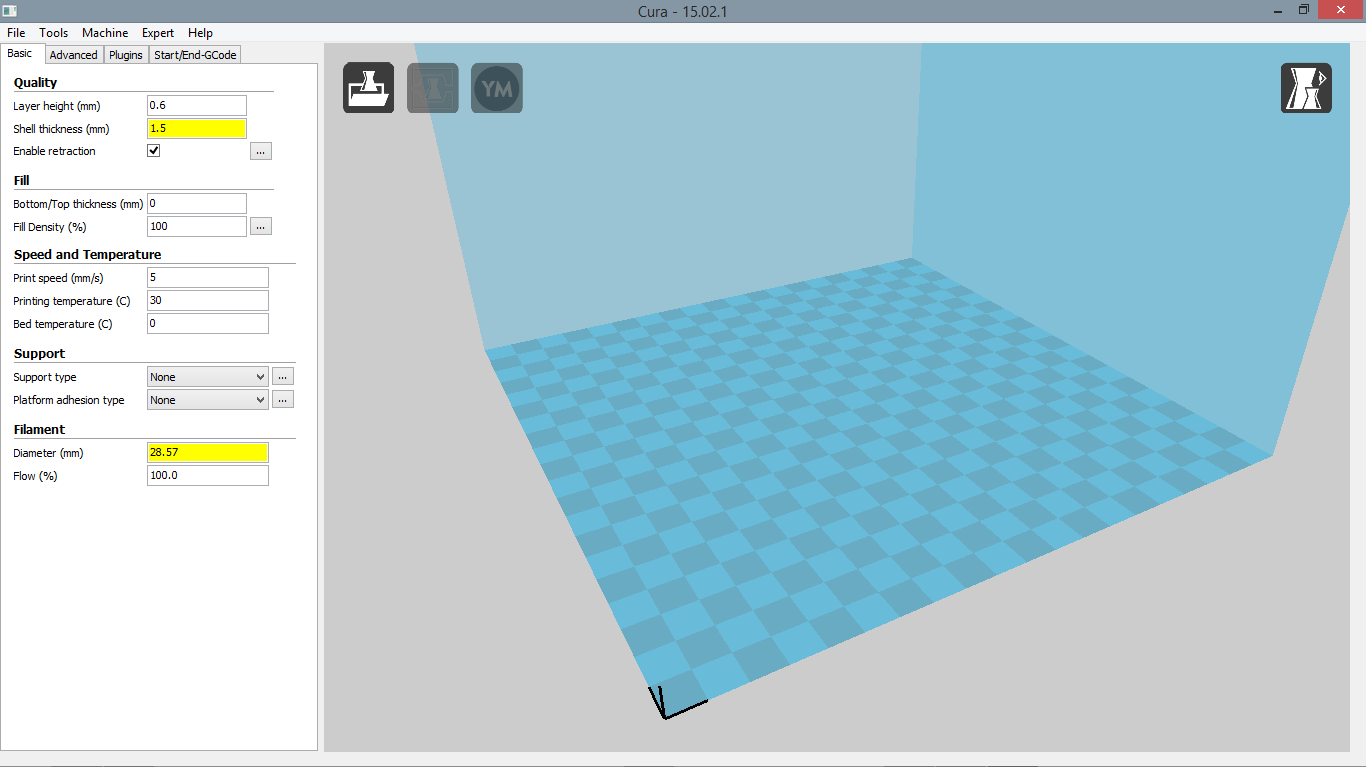
[picture p39: link_img/14.PNG]


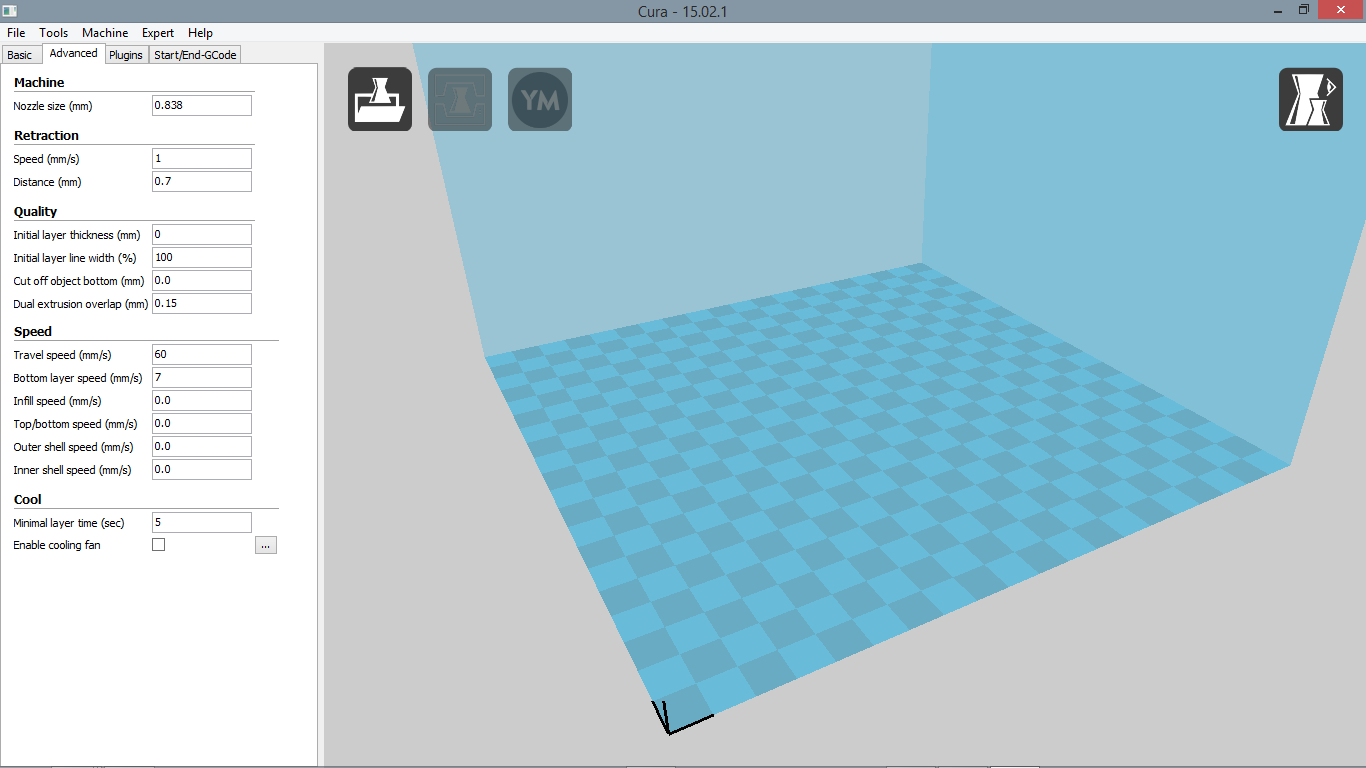
[picture p40: link_img/15.PNG]
