Giuzzo/Giuzzo.github.io/(commit log)

2015-05-17 assemblaggio 3drag
2015-05-17 modifica assemblaggio
2015-05-17 test di stampa
2015-05-21 case histrory
2015-05-22 modello 3drag
    [3drag.iam, 3drag.stp, ANSI (in).dwg, ANSI (in).idw, ANSI (mm).dwg, ANSI (mm).idw, BSI.dwg, BSI.idw]
2015-06-19 table test
    [3drag.iam, 3drag.stp, ANSI (in).dwg, ANSI (in).idw, ANSI (mm).dwg, ANSI (mm).idw, BSI.dwg, BSI.idw]
